robogenesishub05-gamma/robotic_hand_teleop_with_computer_vision/3d_files/Left_Hand.stl

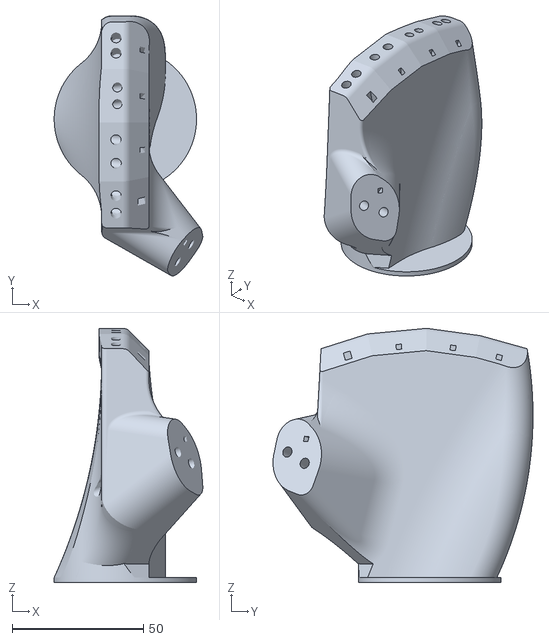
[picture p7: CAD file, 2026-11-14]
3d_files/Left_Hand.stl
56.5 x 98.9 x 96.8
