robogenesishub05-gamma/robotic_hand_teleop_with_computer_vision/landmark_reader.py

import cv2
import time
import mediapipe as mp
from mediapipe.tasks import python
from mediapipe.tasks.python import vision


base_options = python.BaseOptions(model_asset_path = "hand_landmarker.task")

options = vision.HandLandmarkerOptions(base_options=base_options, num_hands=2,running_mode=vision.RunningMode.VIDEO)

detector = vision.HandLandmarker.create_from_options(options)

mp_drawing = mp.tasks.vision.drawing_utils

mp_hands = mp.tasks.vision.HandLandmarksConnections

mp_drawing_styles = mp.tasks.vision.drawing_styles

# landmark_look = mp_drawing.DrawingSpec(
#     color=(255, 255, 0),   
#     thickness=5,
#     circle_radius=2
# )

# connections_look = mp_drawing.DrawingSpec(
#     color=(0, 0, 255),  
#     thickness=3
# )



cam = cv2.VideoCapture(0)

while cam.isOpened():
    success , frame = cam.read()

    if not success  :
        break

    frame = cv2.flip(frame, 1)
    h,w,_ = frame.shape 

    rgb_frame = cv2.cvtColor(frame,cv2.COLOR_BGR2RGB)

    mp_img = mp.Image(mp.ImageFormat.SRGB,rgb_frame)

    timestamp_ms = int(time.time() * 1000)

    result = detector.detect_for_video(mp_img,timestamp_ms)

    if result.hand_landmarks:
        for hand_landmarks in result.hand_landmarks :
            for landmark_id , landmark in enumerate(hand_landmarks):
                x = landmark.x
                y = landmark.y
                z = landmark.z

                print(x,y,z)

                pixel_x = int(x*w)
                pixel_y = int(y*h)

                print(pixel_x , pixel_y )

            mp_drawing.draw_landmarks(frame, hand_landmarks,mp_hands.HAND_CONNECTIONS,mp_drawing_styles.get_default_hand_landmarks_style(),mp_drawing_styles.get_default_hand_connections_style())

            # mp_drawing.draw_landmarks(frame, hand_landmarks,mp_hands.HAND_CONNECTIONS, landmark_look, connections_look )

    else :
        print("No Hand Detected")

    cv2.imshow("Varad", frame)

    if cv2.waitKey(1) & 0xFF == ord("q"):
        break







cam.release()
cv2.destroyAllWindows()
