robogenesishub05-gamma/robotic_hand_teleop_with_computer_vision/wifi_config_example.py

# Copy this file to wifi_config.py, fill in your network, and upload both
# wifi_config.py and main.py to the ESP32. wifi_config.py is in .gitignore.

WIFI_NAME = "YOUR_WIFI_NAME"
WIFI_PASSWORD = "YOUR_WIFI_PASSWORD"
