robogenesishub05-gamma/robotic_hand_teleop_with_computer_vision/(commit log)

2026-09-04 Added the current states and servo angle dict and GUI
2026-09-06 added the smoothened angles and UDP(sockets), removed unnecessary comments and changed or removed a few variables
2026-10-02 Added the main.py Micro python file for ESP32 (Hardware Side)
2026-10-29 Docs: changed README and documentation according to current code
2026-10-29 Replace Wi‑Fi sample credentials with placeholders
2026-11-06 Fix known issues: debug flag, safer packet parsing, saved thresholds, Wi-Fi config file
    - Final_project.py: put RAW/"No Hand Detected" prints behind DEBUG, remove
    unused leftovers, save slider thresholds to thresholds.json on exit and
    load them at startup
    - main.py: treat non-numeric or non-text packets as malformed instead of
    crashing; read Wi-Fi details from wifi_config.py
    - Add wifi_config_example.py; ignore wifi_config.py and thresholds.json
    - Update README and DOCUMENTATION to match
2026-11-14 Add STL files for the 3D printed hand
